SoifaAlpaca/voice-detector/report/main.tex

\documentclass[12pt]{article}
% ----------------------------------------------------------------------
% Define external packages, language, margins, fonts, new commands 
% and colors
% ----------------------------------------------------------------------
\usepackage[utf8]{inputenc} % Codification
\usepackage[english]{babel} % Writing idiom

\usepackage[export]{adjustbox} % Align images
\usepackage{amsmath} %a Extra commands for math mode
\usepackage{amssymb} % Mathematical symbols
\usepackage{anysize} % Personalize margins
    \marginsize{2cm}{2cm}{2cm}{2cm} % {left}{right}{above}{below}
\usepackage{appendix} % Appendices
\usepackage{cancel} % Expression cancellation
\usepackage{caption} % Captions
    \captionsetup{labelfont={bf}}
\usepackage{cite} % Citations, like [1 - 3]
\usepackage{color} % Text coloring
\usepackage{fancyhdr} % Head note and footnote
    \pagestyle{fancy}
    \fancyhf{}
    \fancyhead[L]{
        
    } % Left of Head note
    \fancyhead[R]{\footnotesize Electronics for Micro-Systems} % Right of Head note
    \fancyfoot[L]{\footnotesize MEEC/MIEEC} % Left of Footnote
    \fancyfoot[R]{\thepage  } % Center of Footnote
    %\fancyfoot[R]{\footnotesize Degree} % Right of Footnote
    \renewcommand{\footrulewidth}{0.4pt} % Footnote rule
\usepackage{float} % Utilization of [H] in figures
\usepackage{graphicx} % Figures in LaTeX
\usepackage[colorlinks = true, plainpages = true, linkcolor = novablue, urlcolor = novablue, citecolor = novablue, anchorcolor = novablue]{hyperref}
\usepackage{indentfirst} % First paragraph
\usepackage[super]{nth} % Superscripts
\usepackage{siunitx} % SI units
\usepackage{subcaption} % Subfigures
\usepackage{titlesec} % Font
    \titleformat{\section}{\Large\bfseries}{\thesection}{1em}{}
    \titleformat{\subsection}{\large\bfseries}{\thesubsection}{1em}{}
    \titleformat{\subsubsection}{\normalsize\bfseries}{\thesubsubsection}{1em}{}
    %\fancyfoot[C]{\thepage}

%code
\usepackage[breakable]{tcolorbox}

% Code highlighting
\usepackage{listings}

\usepackage{minted}

\lstset{ 
    backgroundcolor=\color{cellbackground}, % background color for the code block
    basicstyle=\ttfamily,                   % font style
    breakatwhitespace=false,                % automatic breaks only at whitespace
    breaklines=true,                        % automatic line breaking
    captionpos=b,                           % caption position
    commentstyle=\color{gray},              % comment style
    escapeinside={\%*}{*)},                 % if you want to add LaTeX within your code
    keywordstyle=\color{blue},              % keyword style
    stringstyle=\color{dkgreen},            % string style
    frame=single,                           % adds a frame around the code
    rulecolor=\color{cellborder},           % border color
}

%---------TIKZ CONFIG---------%
%Block diagram
\usepackage{tikz}
\usetikzlibrary{shapes.geometric, arrows}
% Define custom color lightblue
\definecolor{lightblue}{RGB}{173, 216, 230}
\tikzstyle{block} = [draw, rectangle, 
    minimum height=2.5em, minimum width=3.5em]
\tikzstyle{arrow} = [thick,->,>=stealth]

\usepackage{xcolor}

% Define a custom light blue color
\definecolor{lightblue}{RGB}{173, 216, 230}

% Define styles with blue shades
\tikzstyle{startstop} = [rectangle, rounded corners, minimum width=3cm, minimum height=1cm, text centered, draw=black, fill=blue!30]
\tikzstyle{process} = [rectangle, minimum width=3cm, minimum height=1cm, text centered, draw=black, fill=cyan!30]
\tikzstyle{decision} = [diamond, minimum width=3cm, minimum height=1cm, text centered, draw=black, fill=lightblue]

%---------TIKZ CONFIG---------%

% Exact colors from NB
\definecolor{incolor}{HTML}{303F9F}
\definecolor{outcolor}{HTML}{D84315}
\definecolor{cellborder}{HTML}{CFCFCF}
\definecolor{cellbackground}{HTML}{F7F7F7}

%folders .tex
\usepackage{subfiles}

% Random text (not needed)
\usepackage{lipsum}
\usepackage{duckuments}

% Tables
\usepackage{tabularx} 
\usepackage{booktabs}
\usepackage{makecell}

% New and re-newcommands
\newcommand{\sen}{\operatorname{\sen}} % Sine function definition
\newcommand{\HRule}{\rule{\linewidth}{0.5mm}} % Specific rule definition
\renewcommand{\appendixpagename}{\LARGE Appendices}

% Colors

\definecolor{novablue}{RGB}{0, 101, 189}
\definecolor{dkgreen}{RGB}{52,129,65}

%%%%%%%%%%%%%%%%%%%%%%%%%%%%%%%%%%%%%%%%%%%%%%%%%%%%%%%%%%%%%%%%%%%%%%%%
%                                 Document                             %
%%%%%%%%%%%%%%%%%%%%%%%%%%%%%%%%%%%%%%%%%%%%%%%%%%%%%%%%%%%%%%%%%%%%%%%%
\begin{document}
% Add bibliography data and style
\bibliographystyle{IEEEtran}
% ----------------------------------------------------------------------
% Cover
% ----------------------------------------------------------------------
\begin{center}
    \begin{figure}
        \vspace{-1.0cm}
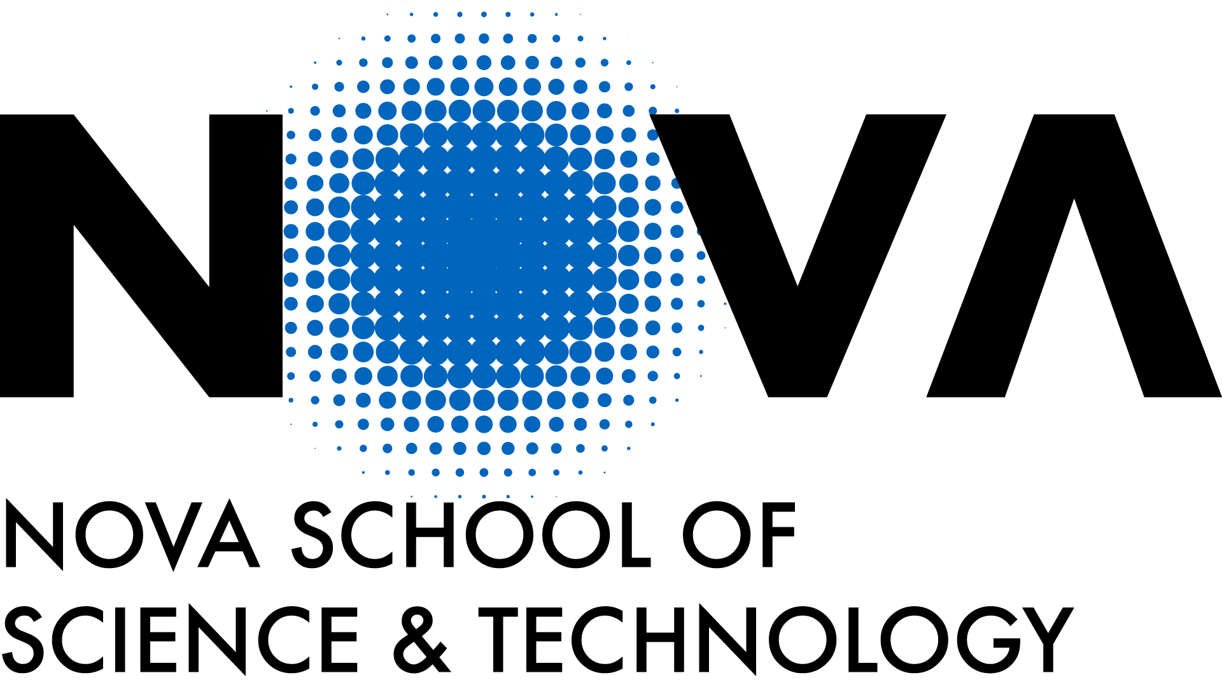
[picture p1: report/Images/NovaFctVer.png]
         % Nova logo
    \end{figure}

    \mbox{}\\[2.0cm]
    \textsc{\Huge MEEC/MIEEC}\\[2cm]
    \textsc{\LARGE Electronics for Micro-Systems}\\[2.0cm]
    \HRule\\[0.4cm]
    {\large \bf {Project \linebreak Voice Activity Detector}}\\[0.2cm] % [\texttt{EN}]
    \HRule\\[1.5cm]
\end{center}

\begin{flushleft}
    \textbf{Authors:}
\end{flushleft}

\begin{center}
    \begin{minipage}{0.5\textwidth}
        \begin{flushleft}
            Martim Duarte Agostinho (70392)\\
            Francisco Simões Coelho Sá da Costa   (70386)\\
            Sofia Margarida Mafra Dias Inácio (58079)\\
        \end{flushleft}
    \end{minipage}%
    \begin{minipage}{0.5\textwidth}
        \begin{flushright}
            \href{mailto:md.agostinho@campus.fct.unl.pt}{\texttt{md.agostinho@campus.fct.unl.pt}}\\
            \href{mailto:fsc.costa@campus.fct.unl.pt}{\texttt{fsc.costa@campus.fct.unl.pt}}\\
            \href{mailto:sm.inacio@campus.fct.unl.pt}{\texttt{sm.inacio@campus.fct.unl.pt}}
        \end{flushright}
    \end{minipage}
\end{center}
 
% Caixa a dizer o grupo
%\begin{flushleft}
%    \large $\boxed{\text{\bf Group} \ \clubsuit}$\\[4.0cm]
%\end{flushleft}

\vspace{4cm}

\begin{center}
    \large \bf 2024/2025 -- \nth{1} Semester - DEEC
\end{center}

\thispagestyle{empty}

\setcounter{page}{0}

\newpage

\newpage

\tableofcontents % Generates the table of contents

\newpage

\listoffigures

\listoftables

\newpage

%\subfile{Sections/Templates.tex}
\subfile{Sections/Introduction.tex}
\subfile{Sections/AnalogFrontEnd.tex}
\subfile{Sections/PMU.tex}
\subfile{Sections/DigitalInterface.tex}
\subfile{Sections/UserInteraction.tex}
\subfile{Sections/ImplementationAndTest.tex}
\subfile{Sections/Conclusion.tex}
\subfile{Sections/FutureWork.tex}

\newpage
\bibliography{references}

\end{document}
