SoifaAlpaca/voice-detector/report/Images/Bias.png

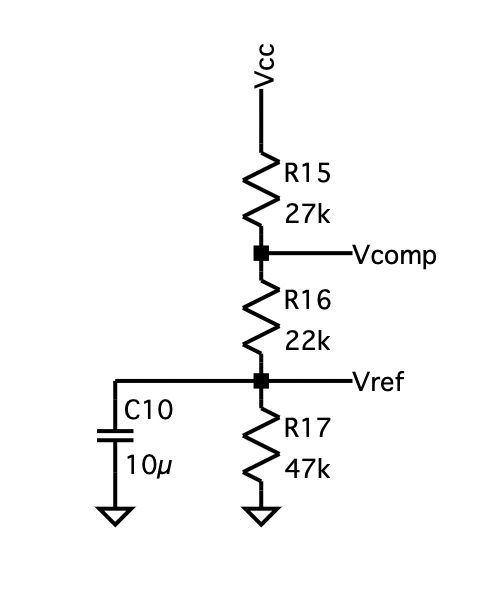
report/Images/Bias.png
