SoifaAlpaca/voice-detector/report/Images/dig_process.png

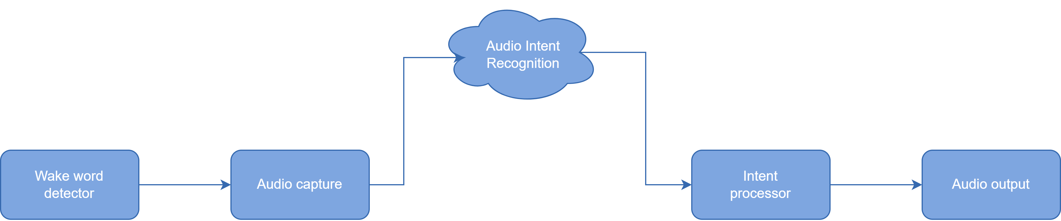
report/Images/dig_process.png
