SoifaAlpaca/voice-detector/report/Images/GrafanaComArch.png

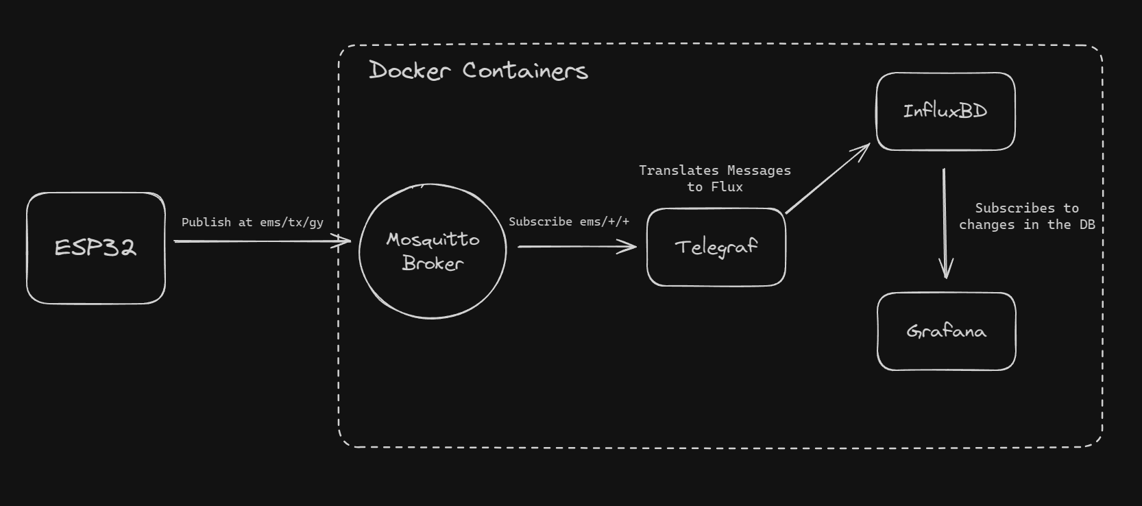
report/Images/GrafanaComArch.png
