SoifaAlpaca/voice-detector/report/Images/Peak and Comp.png

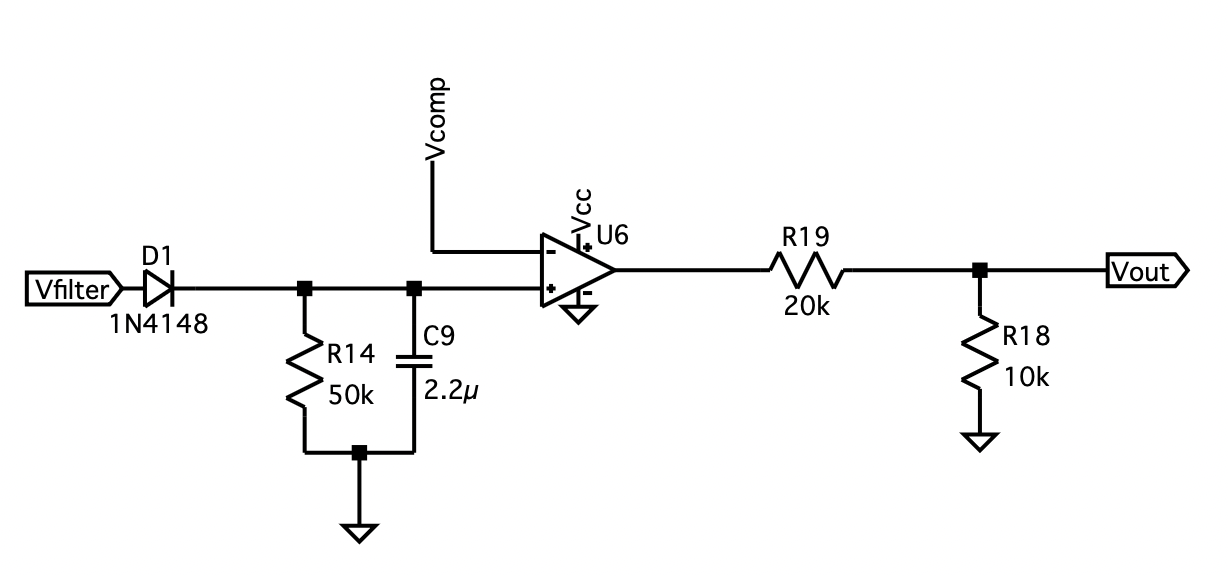
report/Images/Peak and Comp.png
