SoifaAlpaca/voice-detector/ltspice/Draft1.asc

C1: cap; 10n
C2: cap; 10n
C3: cap; 10n
C4: cap; 10n
C5: cap; 10n
C6: cap; 10n
C7: Cap; 10µ
C8: Cap; 10µ
C9: Cap; 2.2µ
C10: Cap; 10µ
C11: Cap; 0.22µ
C12: Cap; 0.1µ
D1: diode; 1N4148
R1: res; 10k
R2: res; 330k
R3: res; 22k
R4: Res; 40k
R5: res; 15k
R6: res; 22k
R7: res; 220k
R8: res; 1.5k
R9: res; 2.2k
R10: res; 22k
R11: Res; 1k
R12: Res; 1k
R13: Res; 70k
R14: Res; 50k
R15: Res; 27k
R16: Res; 22k
R17: Res; 47k
R18: Res; 10k
R19: Res; 20k
U1: opamp2; LM324
U2: opamp2; LM324
U3: opamp2; LM324
U4: opamp2; LM324
U5: opamp2; LM324
U6: opamp2; LM324
U7: 7805
V1: voltage; 9
V4: Voltage; SINE(2 0.355m 1k); AC 1 0
Named nets: 0, Vcc, Vfilter, Vldo, Vref, Vcomp, Vout, Vin, Vamp
.ac dec 1k 1 100k
.tran 10m
.noise V(Vout) V4 dec 1k 10 10k
.lib LM324.ti.lib
