SoifaAlpaca/voice-detector/ltspice/Draft2.asc

C1: cap; {mc(10n, tolC)}
C2: cap; {mc(10n, tolC)}
C3: cap; {mc(10n, tolC)}
C4: cap; {mc(10n, tolC)}
C5: cap; {mc(10n, tolC)}
C6: cap; {mc(10n, tolC)}
C7: Cap; {mc(10n, tolC)}
C8: Cap; {mc(10n, tolC)}
C9: Cap; {mc(10n, tolC)}
C10: Cap; {mc(10n, tolC)}
C11: Cap; {mc(10n, tolC)}
C12: Cap; {mc(10n, tolC)}
C13: Cap; {mc(10u, tolC)}
C14: Cap; {mc(10u, tolC)}
R1: res; {mc(10k, tolR)}
R2: res; {mc(330k, tolR)}
R3: res; {mc(22k, tolR)}
R4: res; {mc(15k, tolR)}
R5: res; {mc(22k, tolR)}
R6: res; {mc(220k, tolR)}
R7: res; {mc(1.5k, tolR)}
R8: res; {mc(2.2k, tolR)}
R9: res; {mc(22k, tolR)}
R10: Res; {mc(10k, tolR)}
R11: Res; {mc(220, tolR)}
R12: Res; {mc(1Meg, tolR)}
R13: Res; {mc(68k, tolR)}
R14: Res; {mc(470, tolR)}
R15: Res; {mc(2.7k, tolR)}
R16: Res; {mc(100k, tolR)}
R17: Res; {mc(39k, tolR)}
R18: Res; {mc(6.8k, tolR)}
R19: Res; {mc(470, tolR)}
R20: Res; {mc(2.7k, tolR)}
R21: Res; {mc(10k, tolR)}
R22: Res; {mc(3.9k, tolR)}
R23: Res; {mc(40k, tolR)}
R24: Res; {mc(1k, tolR)}
R25: Res; {mc(1k, tolR)}
R26: Res; {mc(70k, tolR)}
U1: opamp2; LM324
U2: opamp2; LM324
U3: opamp2; LM324
U4: opamp2; LM324
U5: opamp2; LM324
U6: opamp2; LM324
U7: opamp2; LM324
U8: opamp2; LM324
V1: Voltage; 4.5; AC 1 0
V2: voltage; 9
V3: Voltage; 5
V4: Voltage; 4.5
Named nets: Vcc, 0, Vmfb, Vldo, Vsk, Vin, Vref, Vamp
.lib LM324.ti.lib
.ac dec 1k 1 100k
.step param X 1 200 1
.param tolR = 0.05
.param tolC = 0.05
