SoifaAlpaca/voice-detector/ltspice/Draft3.asc

C1: cap; 10n
C2: cap; 10n
C3: cap; 10n
C4: cap; 10n
C5: cap; 10n
C6: cap; 10n
R1: res; 10k
R2: res; 330k
R3: res; 22k
R4: res; 15k
R5: res; 22k
R6: res; 220k
R7: res; 1.5k
R8: res; 2.2k
R9: res; 22k
U1: opamp2; LM324
U2: opamp2; LM324
U3: opamp2; LM324
V1: Voltage; 4.5; AC 1 0
V2: voltage; 9
V3: Voltage; 5
Named nets: Vcc, 0, Vout, Vref, Vin
.ac dec 1k 10 100k
.tran 10m
.lib LM324.ti.lib
.noise V(Vout) V1 dec 1k 10 10k
