SoifaAlpaca/voice-detector/ltspice/sallen-key.asc

C1: Cap; 10n
C2: Cap; 10n
C3: Cap; 10n
C4: Cap; 10n
C5: Cap; 10n
C6: Cap; 10n
R1: Res; 10k
R2: Res; 220
R3: Res; 1Meg
R4: Res; 68k
R5: Res; 470
R6: Res; 2.7k
R7: Res; 100k
R8: Res; 39k
R9: Res; 6.8k
R10: Res; 470
R11: Res; 2.7k
R12: Res; 10k
R13: Res; 3.9k
U1: opamp2; LM324
U2: opamp2; LM324
U3: opamp2; LM324
V1: Voltage; 9
V2: Voltage; 4.5; AC 1 0
V3: Voltage; 4.5
Named nets: 0, Vcc, Vin, Vout, Vref
.tran 10m
.ac dec 1k 10 100k
.lib LM324.ti.lib
.noise V(Vout) V2 dec 1k 10 10k
