SoifaAlpaca/voice-detector/ltspice/Untitled.asc

C1: Cap; 2.2µ
C2: Cap; 10µ
C3: Cap; 10µ
C4: Cap; 10µ
D1: diode; 1N4148
R1: Res; 50k
R2: Res; 27k
R3: Res; 22k
R4: Res; 47k
R5: Res; 40k
R6: Res; 1k
R7: Res; 1k
R8: Res; 70k
R9: Res; 10k
R10: Res; 20k
U1: UniversalOpAmp2
U2: UniversalOpAmp2
U3: UniversalOpAmp2
V1: Voltage; 9
V2: Voltage; SINE(4 1.5m 1k 5m 0 0 2)
Named nets: 0, Vcc, Vref, Vcomp, Vamp
.tran 50m
