SoifaAlpaca/voice-detector/include/FIR.h

#ifndef FIR_H
#define FIR_H

#include <vector>
using namespace std;

const std::vector<double> coefs{
    2.186060456387776e-20, -1.7719044326455116e-08, -3.6595162349078606e-08, -3.392158374060651e-09, -5.612473282261062e-08, -3.5072578807022383e-07, -6.103598038428218e-07, -3.6916890031509583e-07, 1.3286928872810246e-07, -3.773195884319177e-08, -1.0586178669085158e-06, -1.575958800414019e-06, -4.226801580955585e-07, 1.231082339412113e-06, 9.857398717636869e-07, -1.1365357705232383e-06, -1.8893969588483567e-06, 8.669979602703544e-07, 4.3507341675676794e-06, 3.974573167660684e-06, 1.9548477450697522e-07, -9.689348186091353e-07, 3.892837818488514e-06, 9.658487900021077e-06, 8.777999676219545e-06, 2.402326060204694e-06, 2.8162212715181434e-07, 7.436058567776373e-06, 1.5623165806806167e-05, 1.3496101611216299e-05, 3.1911448458738366e-06, -7.489322220868384e-07, 8.685938524009943e-06, 1.9292262282625707e-05, 1.5021651180102577e-05, -6.790181263249441e-07, -7.305519038538674e-06, 4.567099145276562e-06, 1.785486366788464e-05, 1.081335399472379e-05, -1.1445426881989943e-05, -2.1173813645830163e-05, -6.069286676230868e-06, 1.0882863130899258e-05, 1.1343999204040203e-06, -2.8161273709743906e-05, -4.0614954022416074e-05, -2.0552757093299395e-05, 1.9938658224289747e-06, -9.570192508037424e-06, -4.565619536855528e-05, -5.9711157338274684e-05, -3.2165484783600945e-05, -1.3814539093245983e-06, -1.3393380627169127e-05, -5.57602103667764e-05, -7.010015366701176e-05, -3.238256312345365e-05, 9.270231034564965e-06, -2.1595330422113487e-06, -5.092119057123971e-05, -6.496579598669818e-05, -1.5173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
};

#endif
