SoifaAlpaca/voice-detector/src/config.cpp

#include "config.h"

bool no_mqtt  = true;
bool no_sleep = false;

RTC_DATA_ATTR unsigned int sleep_time = 20000;
RTC_DATA_ATTR float        volume     = 0.6;
RTC_DATA_ATTR uint8_t      led_status = HIGH;

// i2s config for reading from both channels of I2S
i2s_config_t i2sMemsConfigBothChannels = {
    .mode = (i2s_mode_t)(I2S_MODE_MASTER | I2S_MODE_RX),
    .sample_rate = 16000,
    .bits_per_sample = I2S_BITS_PER_SAMPLE_32BIT,
    .channel_format = I2S_MIC_CHANNEL,
    .communication_format = i2s_comm_format_t(I2S_COMM_FORMAT_STAND_I2S),
    .intr_alloc_flags = ESP_INTR_FLAG_LEVEL1,
    .dma_buf_count = 4,
    .dma_buf_len = 64,
    .use_apll = false,
    .tx_desc_auto_clear = false,
    .fixed_mclk = 0
    };

// i2s microphone pins
i2s_pin_config_t i2s_mic_pins = {
    .bck_io_num = I2S_MIC_SERIAL_CLOCK,
    .ws_io_num = I2S_MIC_LEFT_RIGHT_CLOCK,
    .data_out_num = I2S_PIN_NO_CHANGE,
    .data_in_num = I2S_MIC_SERIAL_DATA
    };

// i2s speaker pins
i2s_pin_config_t i2s_speaker_pins = {
    .bck_io_num = I2S_SPEAKER_SERIAL_CLOCK,
    .ws_io_num = I2S_SPEAKER_LEFT_RIGHT_CLOCK,
    .data_out_num = I2S_SPEAKER_SERIAL_DATA,
    .data_in_num = I2S_PIN_NO_CHANGE
    };

WiFiClient espClient;
PubSubClient client(espClient);
