SoifaAlpaca/voice-detector/include/Creds.h

#ifndef CREDS_H
#define CREDS_H

extern const char *ssid;
extern const char *password;
extern const char *mqttpass;
extern const char *mqttuser;
extern const char *mqttClientID;
extern const char *mqtt_server;
extern const unsigned int mqttPort;

// command recognition settings
#define COMMAND_RECOGNITION_ACCESS_KEY "WKLQFIKHZRX5UBGG65ANBIL6Q6TEGH4S"

#endif
