SoifaAlpaca/voice-detector/include/IndicatorLight.h

#ifndef _indicator_light_h_
#define _indicator_light_h_

enum IndicatorState
{
    OFF,
    ON,
    PULSING
};

class IndicatorLight
{
private:
    IndicatorState m_state;
    TaskHandle_t m_taskHandle;

public:
    IndicatorLight();
    void setState(IndicatorState state);
    IndicatorState getState();
};

#endif
