SoifaAlpaca/voice-detector/src/Listen.cpp

#include <Arduino.h>
#include "Listen.h"
#include "state_machine/DetectWakeWordState.h"
#include "state_machine/RecogniseCommandState.h"
#include "IndicatorLight.h"
#include "Speaker.h"
#include "IntentProcessor.h"

bool listening = true;

Listen::Listen(I2SSampler *sample_provider, IntentProcessor *intent_processor, Speaker *speaker, IndicatorLight *indicator_light)
{
    // detect wake word state - waits for the wake word to be detected
    m_detect_wake_word_state = new DetectWakeWordState(sample_provider);
    // command recongiser - streams audio to the server for recognition
    m_recognise_command_state = new RecogniseCommandState(sample_provider, indicator_light, speaker, intent_processor);
    // start off in the detecting wakeword state
    m_current_state = m_detect_wake_word_state;
    m_current_state->enterState();
}

// process the next batch of samples
void Listen::run()
{
    bool state_done = m_current_state->run();

    if (state_done)
    {
        m_current_state->exitState();
        // switch to the next state - very simple state machine so we just go to the other state...
        if (m_current_state == m_detect_wake_word_state){

            listening = true;
            m_current_state = m_recognise_command_state;
        }
        else{
            
            listening = false;
            m_current_state = m_detect_wake_word_state;
        }
        m_current_state->enterState();
    }
    vTaskDelay(10);
}
