SoifaAlpaca/voice-detector/(commit log)

2024-11-14 ellip and cheb filter
2024-11-21 bode analog real
    [emsfinalanalogbode.csv]
2024-11-22 python funcs
    [emsfinalanalogbode.csv]
2024-12-27 gui + mqtt + grafana + Home Assistant + header file fix
    [Creds.h, MQTT.cpp, MQTT.h, RTOSTask.cpp, RTOSTask.h, gui.py, interaction.cpp, interaction.h]
2025-01-06 wired connection report section
2025-01-07 file config/creds fix plus file organization
    [Creds.h, FIR.h, Filter.h, IndicatorLight.h, IntentProcessor.h, Listen.h, MQTT.cpp, MQTT.h]
